NZAquaBots/nzaquabots.github.io/images/Kit parts.jpeg

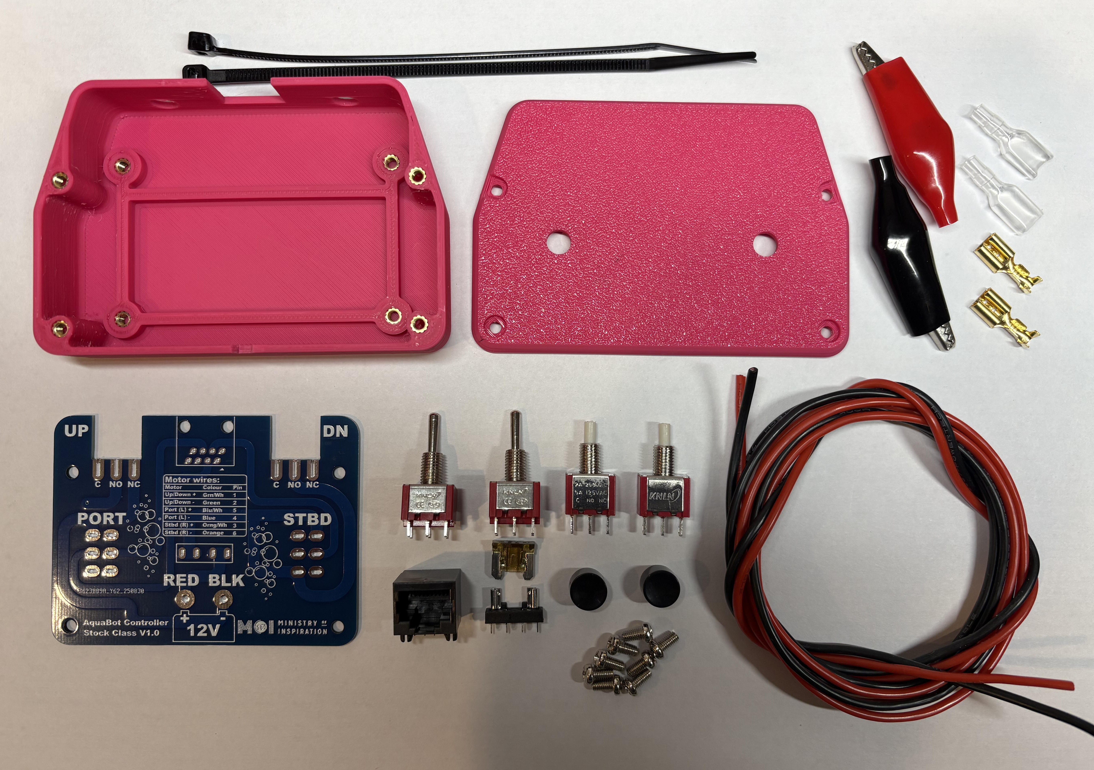
images/Kit parts.jpeg
