NZAquaBots/nzaquabots.github.io/images/PCB parts.jpeg

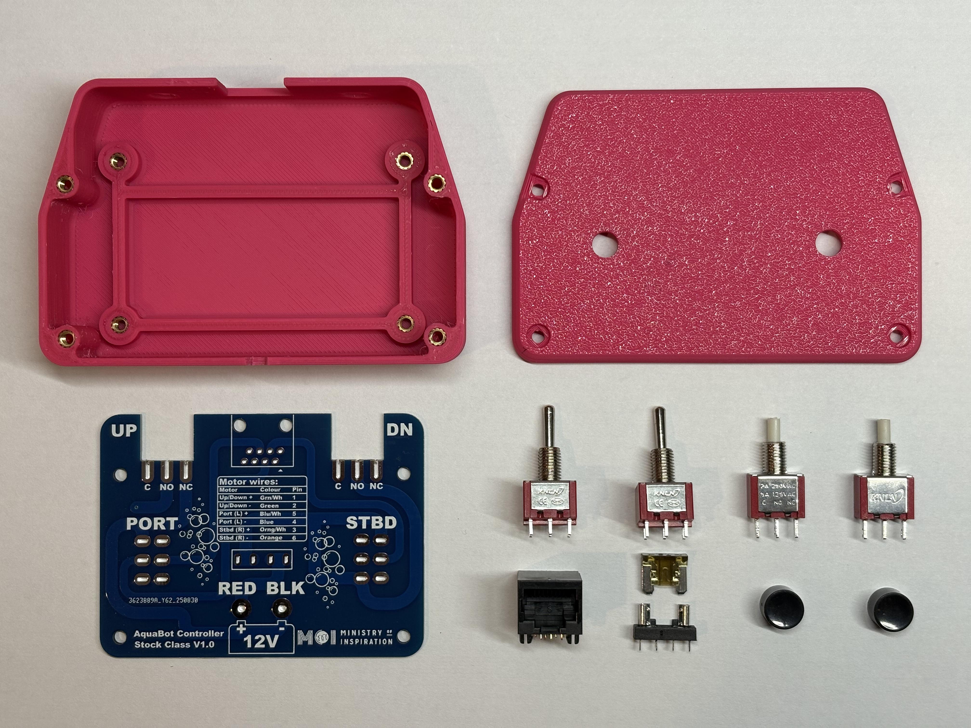
images/PCB parts.jpeg
