NZAquaBots/nzaquabots.github.io/ECAD/AquaBot Stock Controller Schematic.pdf

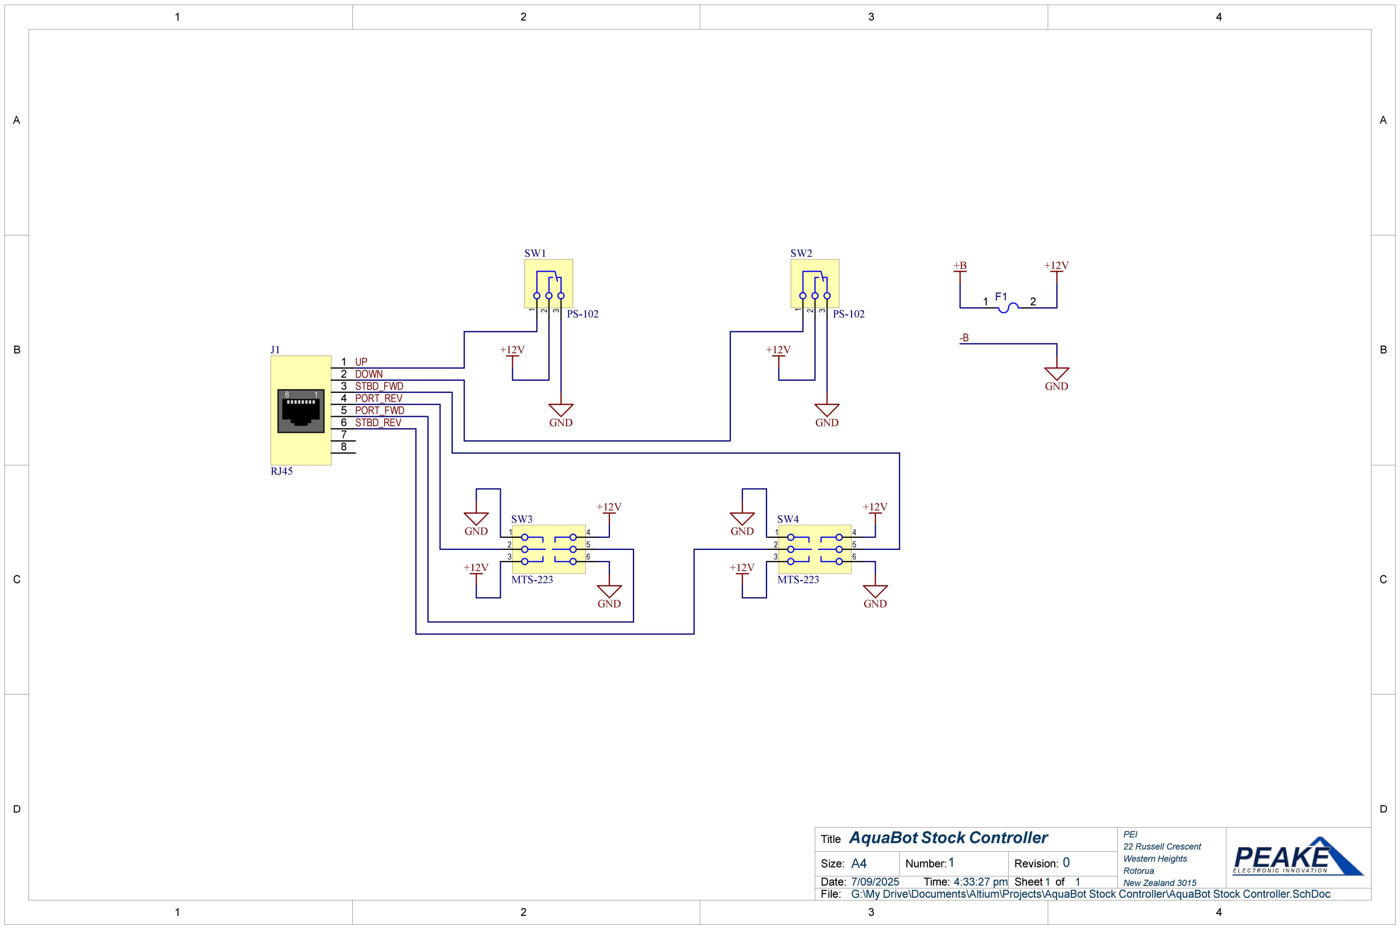
[picture p3: page 1]

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
### 22 Russell Crescent

Western Heights
Rotorua

### 1 New Zealand 3015

## AquaBot Stock Controller

1 0

7/09/2025 | 4:33:27 pm
G:\My Drive\Documents\Altium\Projects\AquaBot Stock Controller\AquaBot Stock Controller.SchDoc

Title

Size: | Number:
Date:
File:

Revision:
Time: | Sheet of

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
MTS-223

1
2

3

SW2

PS-102

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
RJ45

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
MTS-223

1
2

3

SW1

PS-102

+B | +12V

GND

-B
+12V | +12V
GND | GND
+12V | +12V
+12V | +12V
GND | GND
GND | GND

UP
DOWN
STBD_FWD

STBD_REV

PORT_FWD

PORT_REV
