NZAquaBots/nzaquabots.github.io/3d models/AngledEnclosure/AngledEnclosure.png

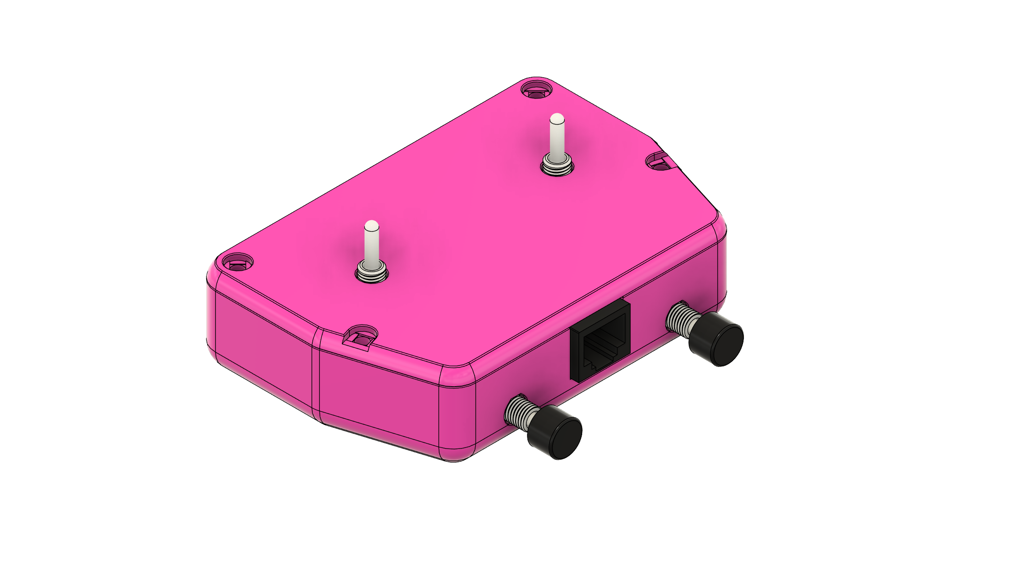
3d models/AngledEnclosure/AngledEnclosure.png
