NZAquaBots/nzaquabots.github.io/images/1.jpeg

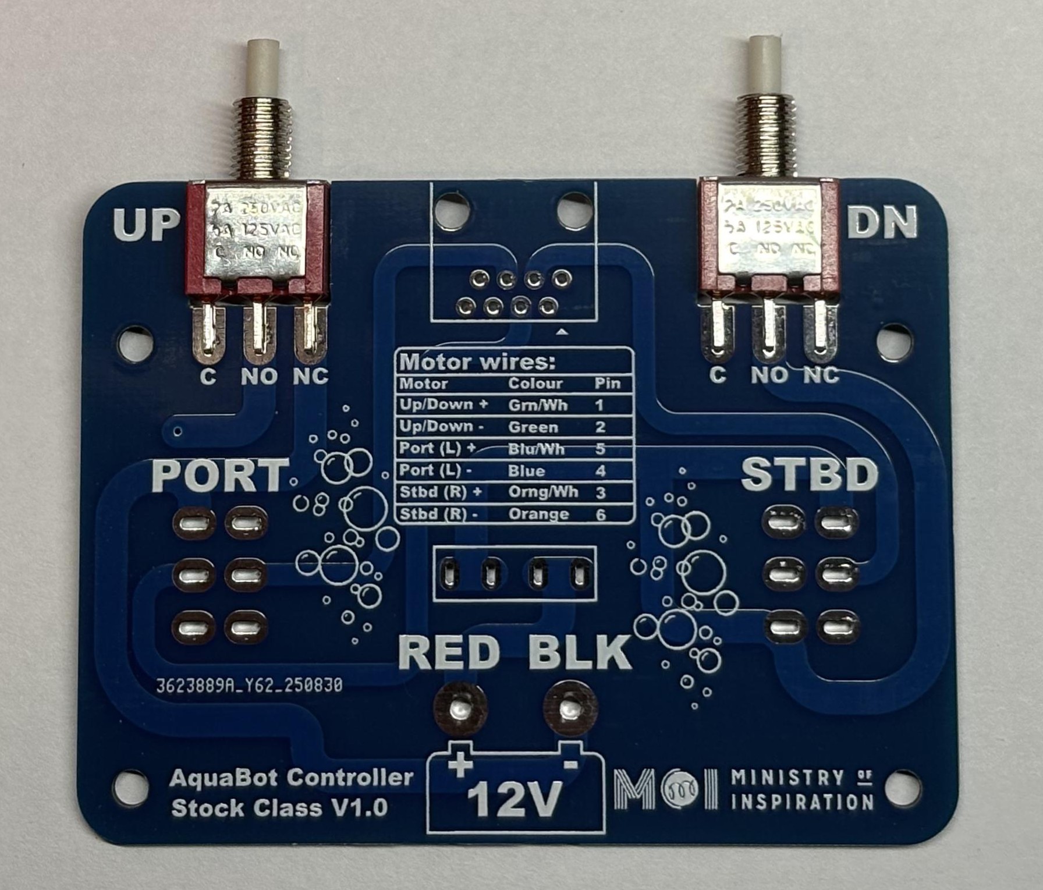
images/1.jpeg
