NZAquaBots/nzaquabots.github.io/images/2.jpeg

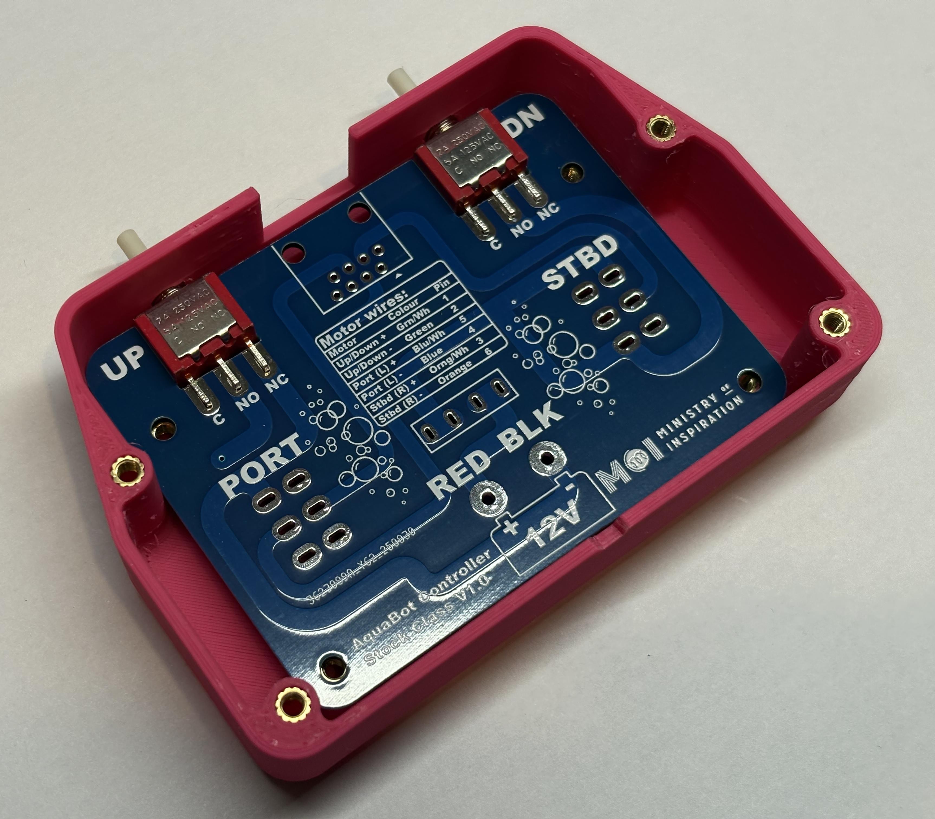
images/2.jpeg
