NZAquaBots/nzaquabots.github.io/images/3.jpeg

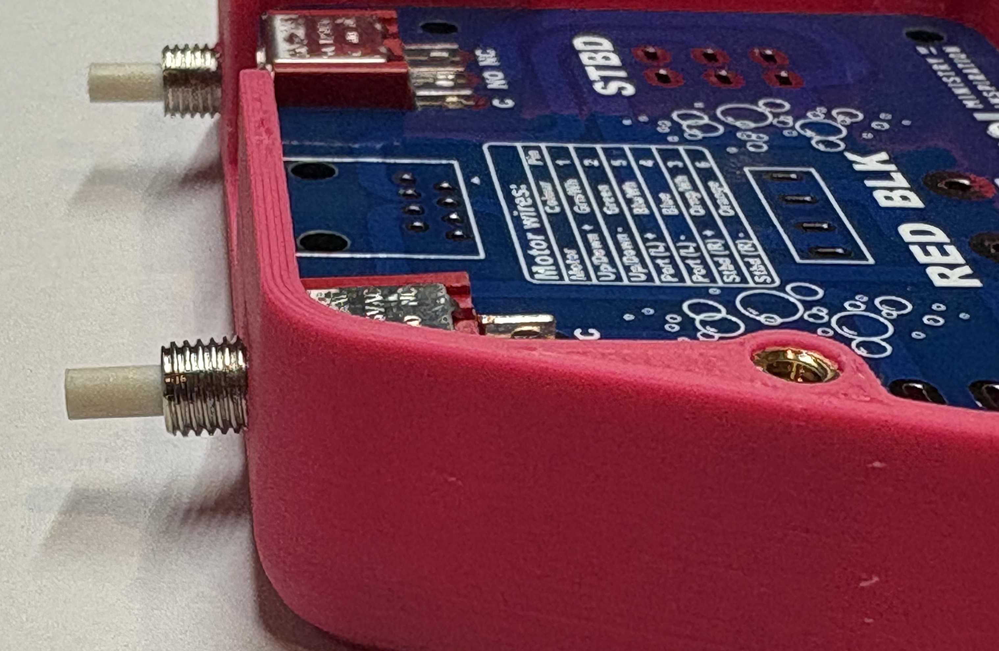
images/3.jpeg
