NZAquaBots/nzaquabots.github.io/images/4A.jpeg

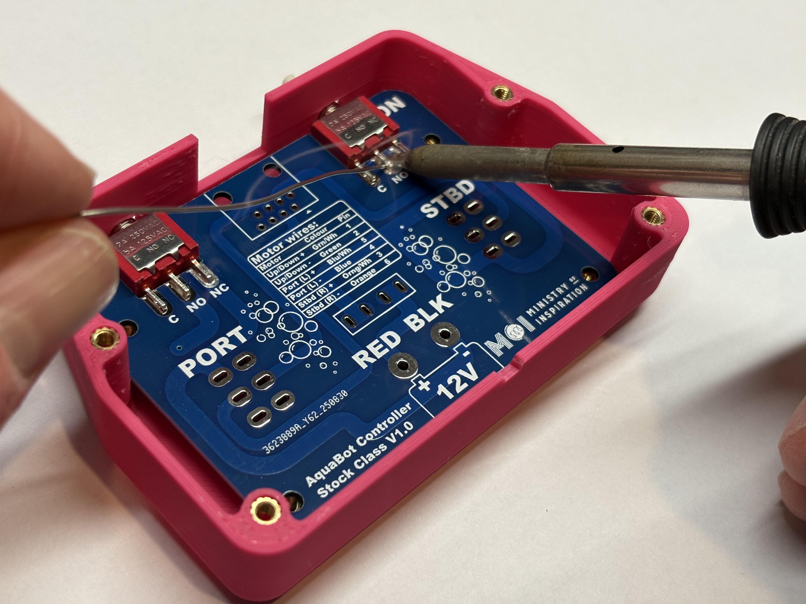
images/4A.jpeg
