NZAquaBots/nzaquabots.github.io/images/4B.jpeg

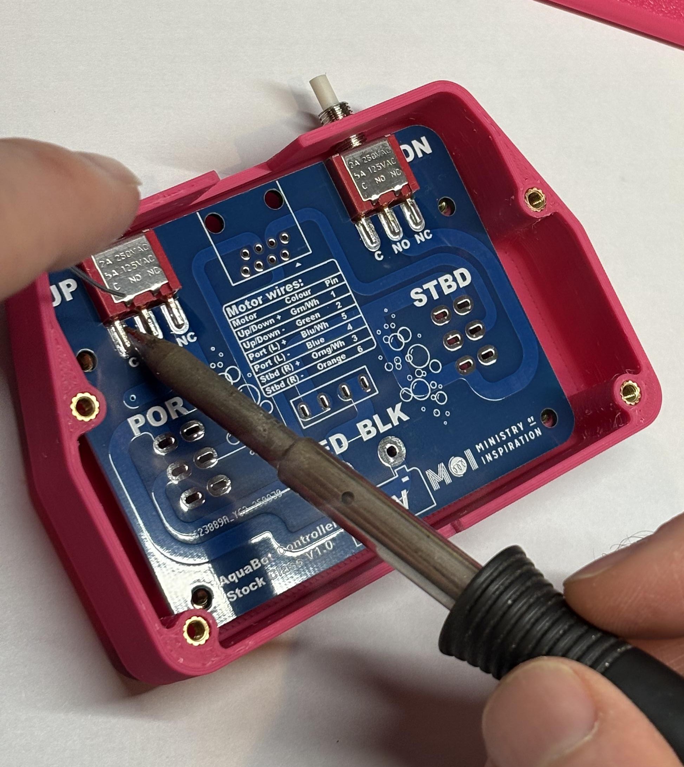
images/4B.jpeg
