NZAquaBots/nzaquabots.github.io/images/4C.jpeg

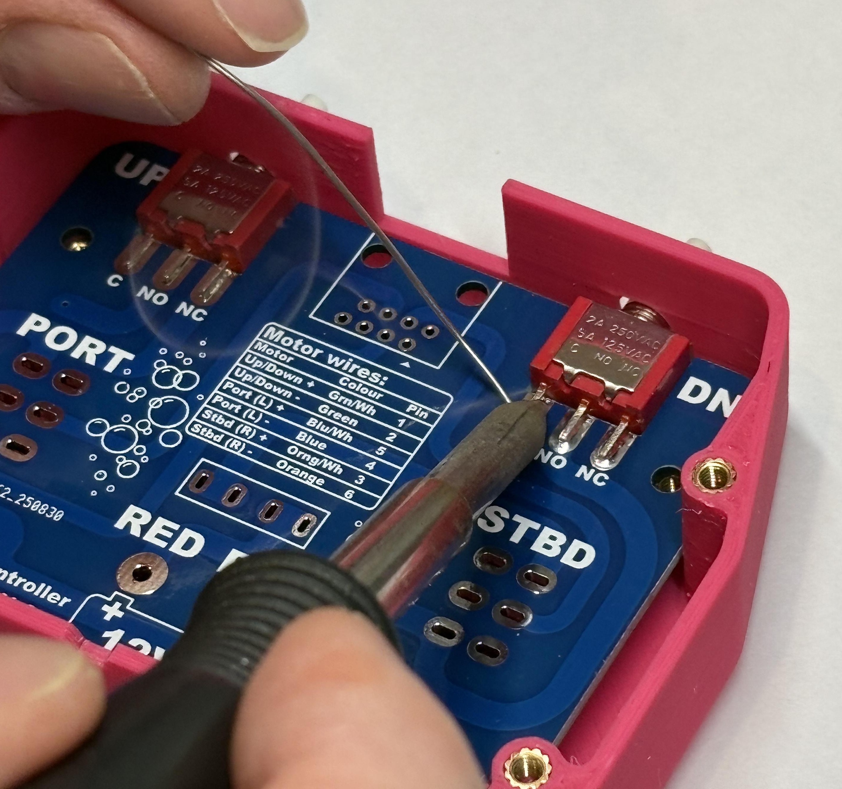
images/4C.jpeg
