NZAquaBots/nzaquabots.github.io/images/5.jpeg

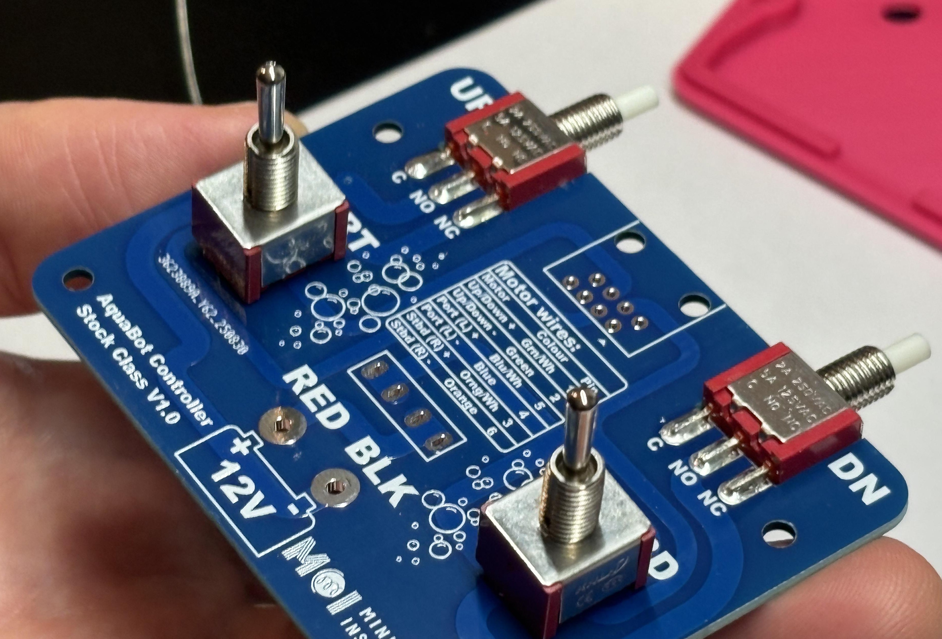
images/5.jpeg
