NZAquaBots/nzaquabots.github.io/images/6.jpeg

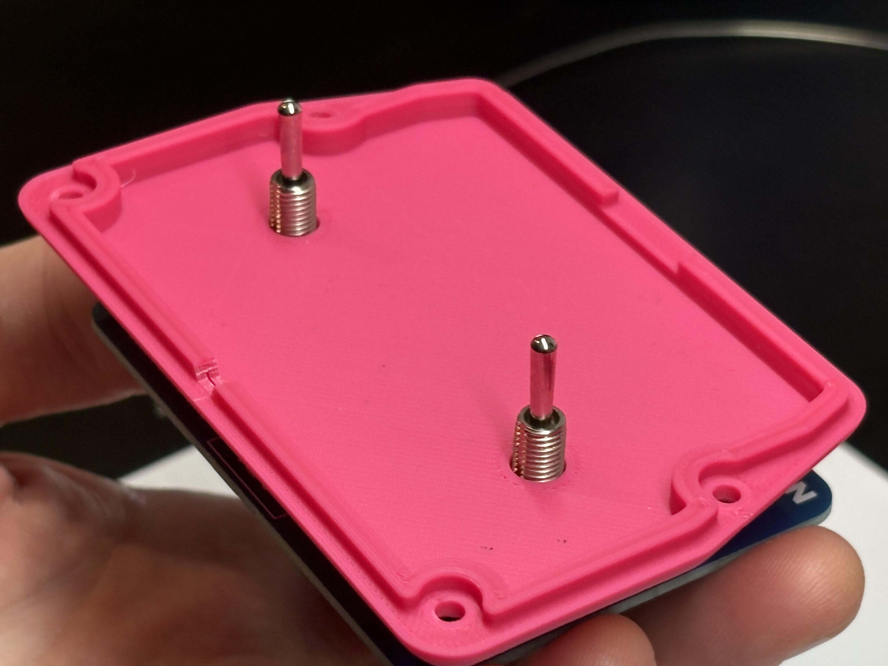
images/6.jpeg
