NZAquaBots/nzaquabots.github.io/images/7.jpeg

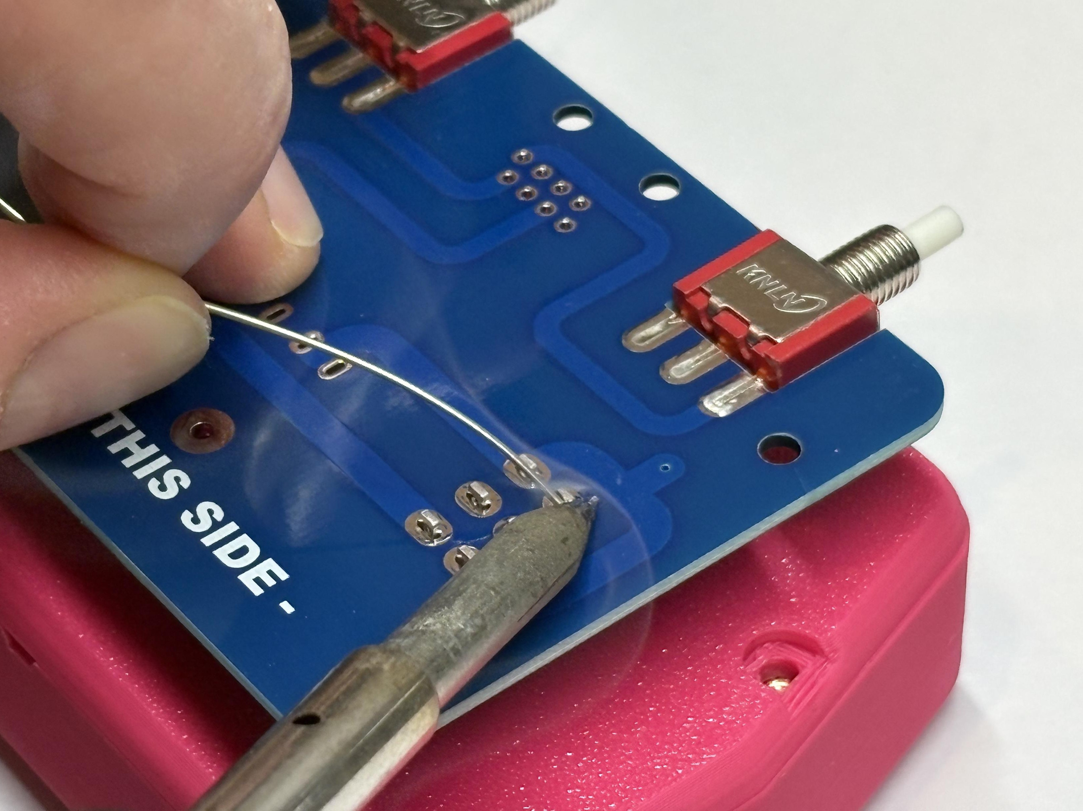
images/7.jpeg
