NZAquaBots/nzaquabots.github.io/images/8.jpeg

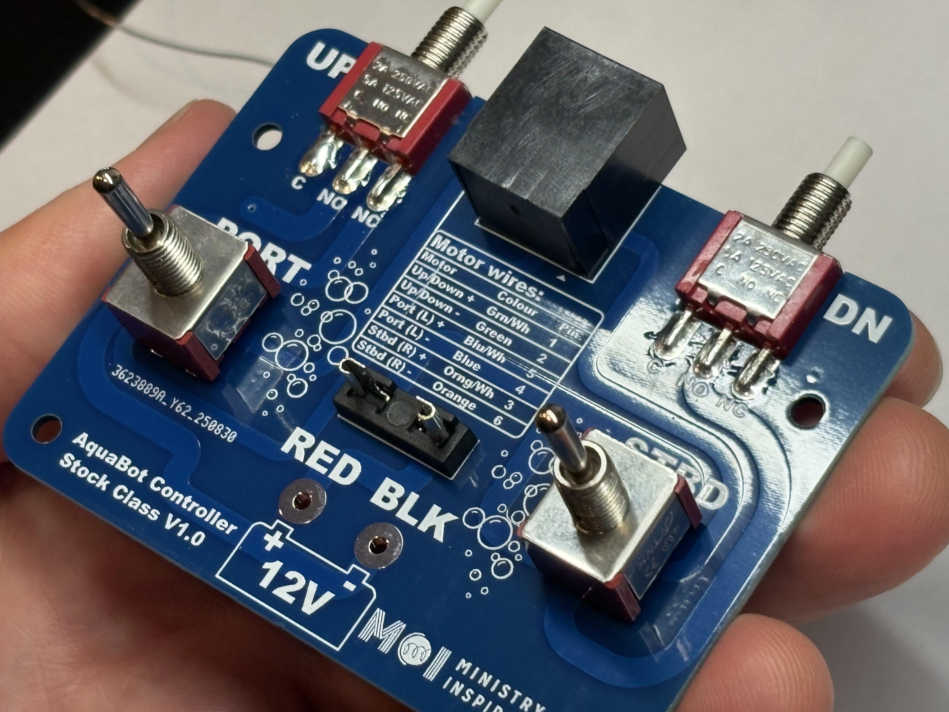
images/8.jpeg
