NZAquaBots/nzaquabots.github.io/images/9.jpeg

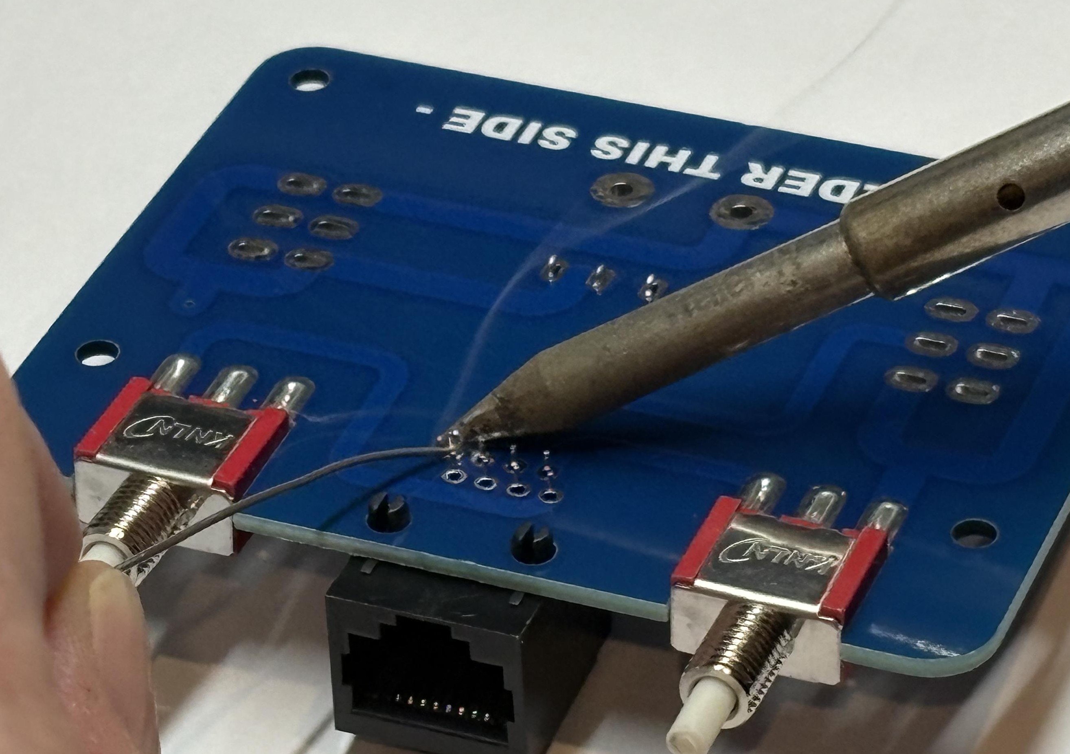
images/9.jpeg
