NZAquaBots/nzaquabots.github.io/images/10.jpeg

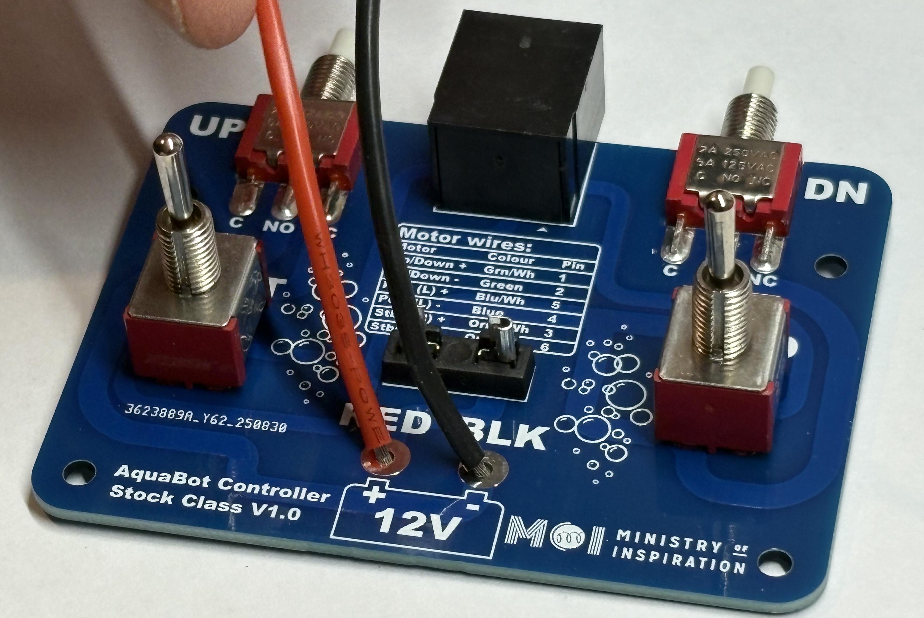
images/10.jpeg
