NZAquaBots/nzaquabots.github.io/images/11.jpeg

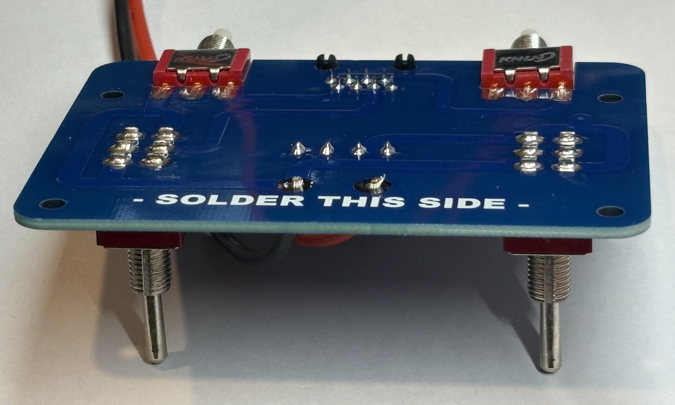
images/11.jpeg
