NZAquaBots/nzaquabots.github.io/images/12A.jpeg

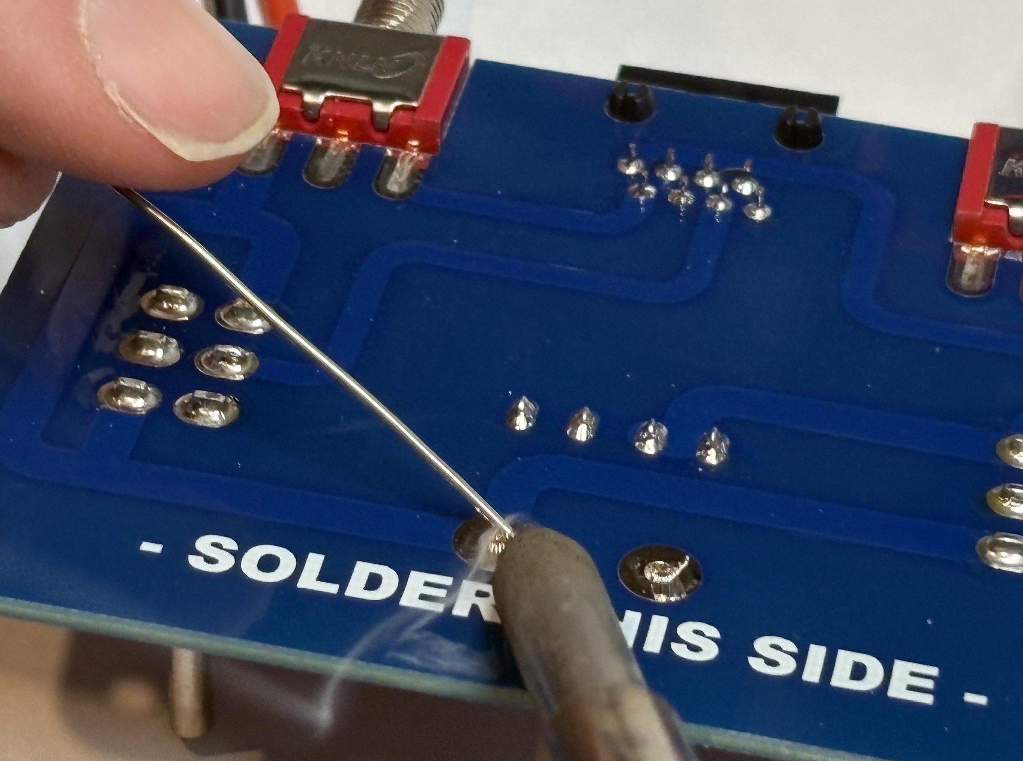
images/12A.jpeg
