NZAquaBots/nzaquabots.github.io/images/12B.jpeg

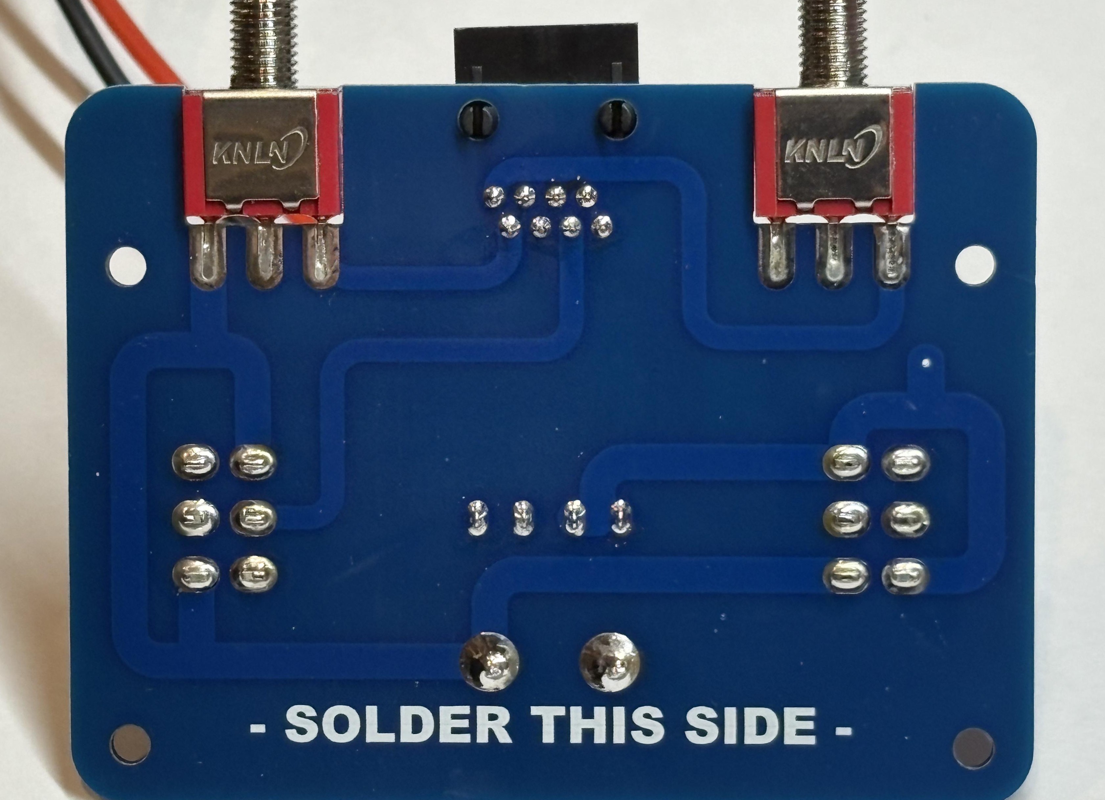
images/12B.jpeg
