NZAquaBots/nzaquabots.github.io/images/13.jpeg

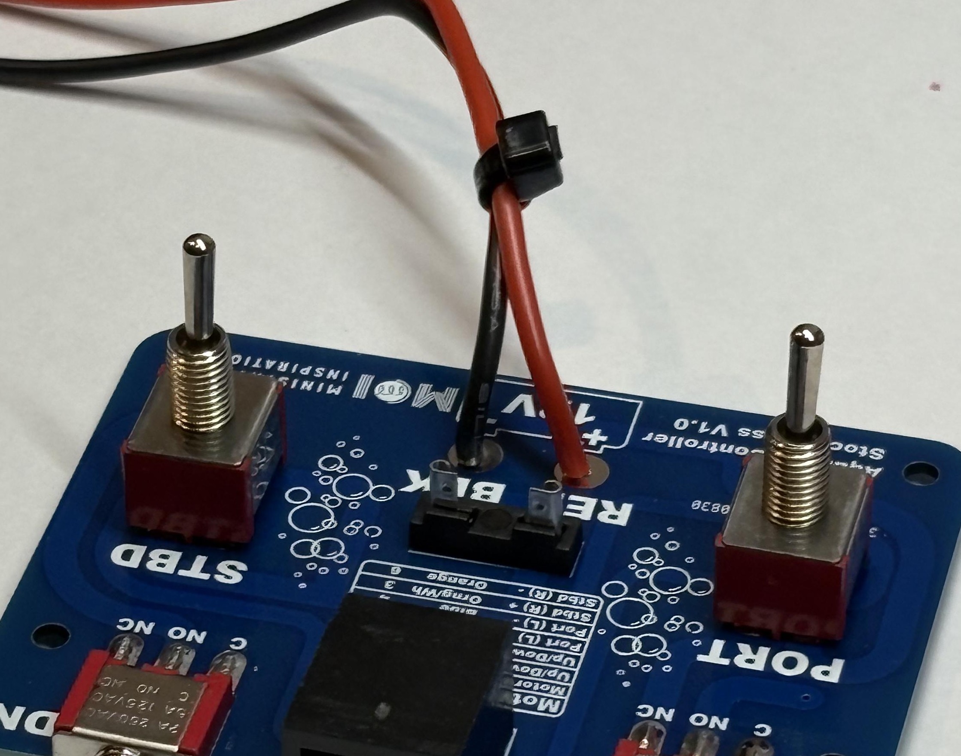
images/13.jpeg
