NZAquaBots/nzaquabots.github.io/images/14.jpeg

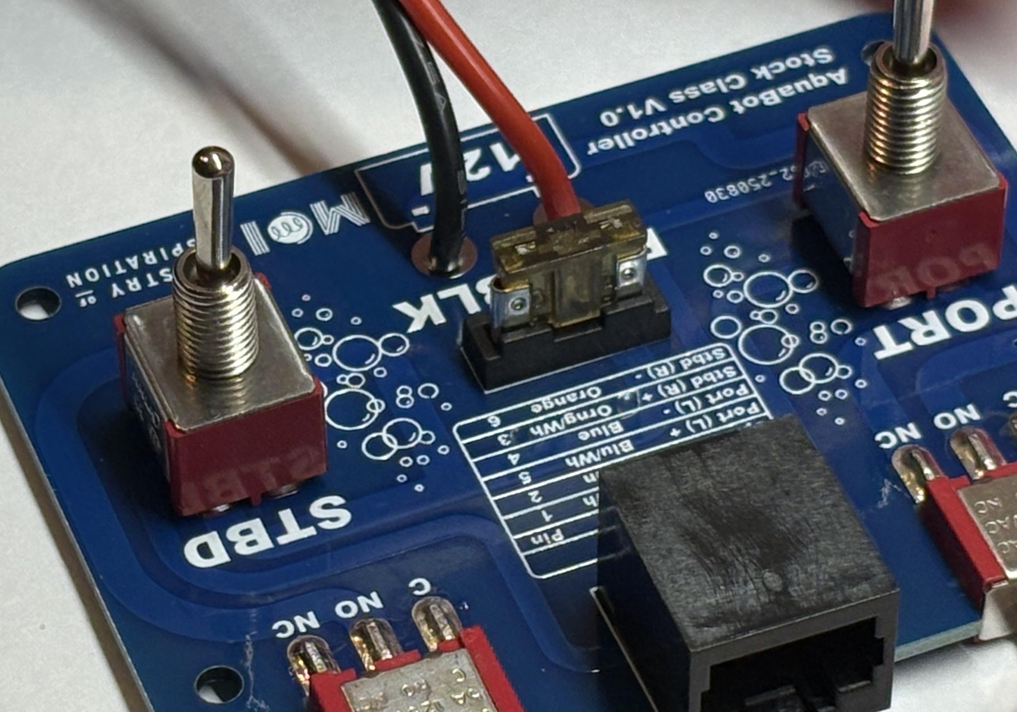
images/14.jpeg
