NZAquaBots/nzaquabots.github.io/images/15.jpeg

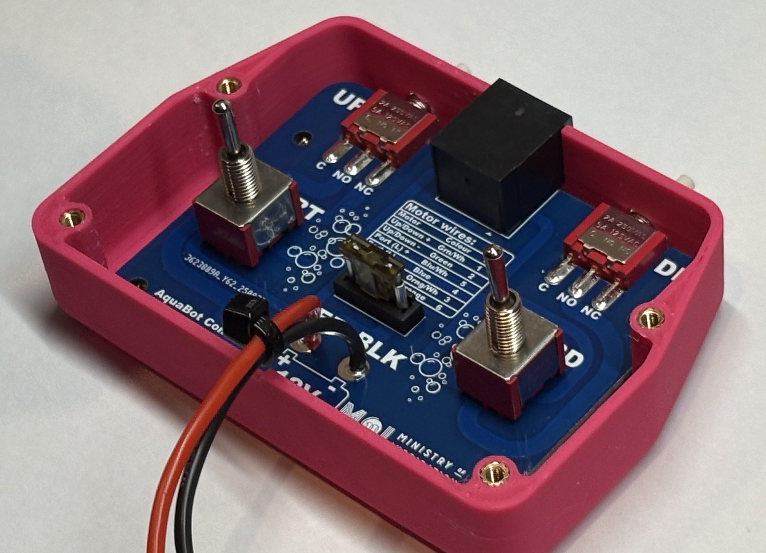
images/15.jpeg
