NZAquaBots/nzaquabots.github.io/images/16.jpeg

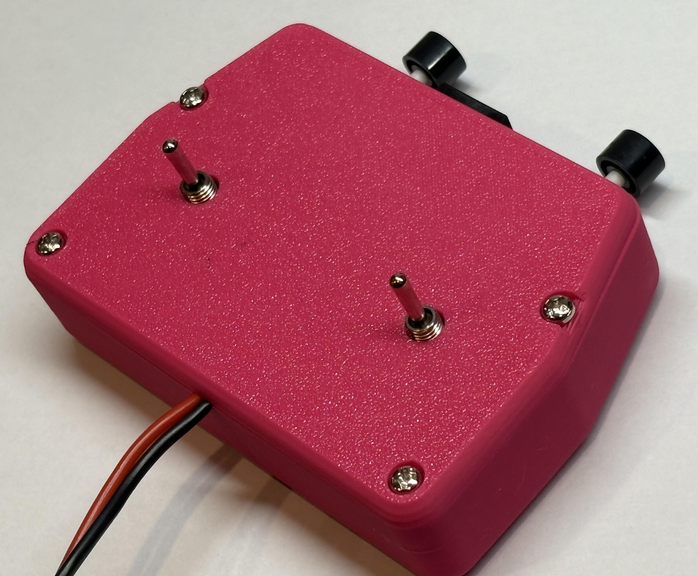
images/16.jpeg
