NZAquaBots/nzaquabots.github.io/images/17.jpeg

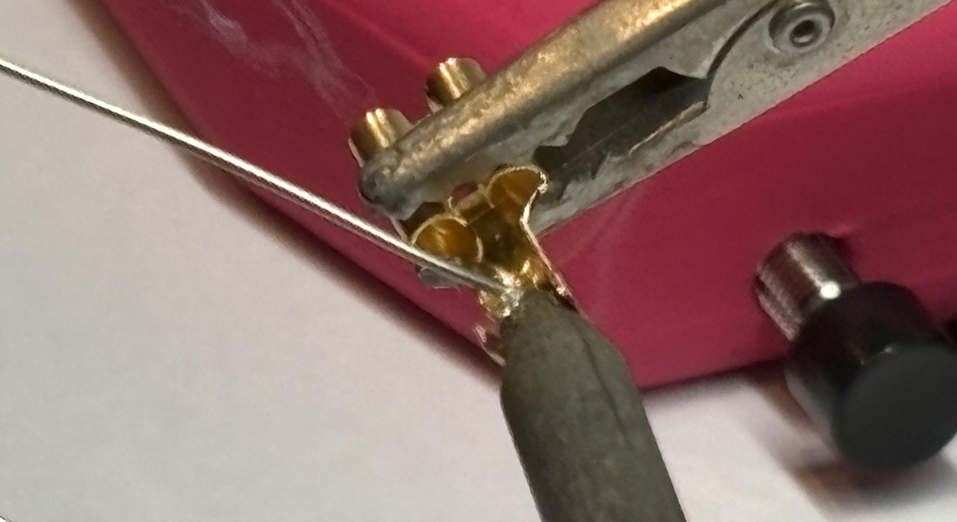
images/17.jpeg
