NZAquaBots/nzaquabots.github.io/images/18.jpeg

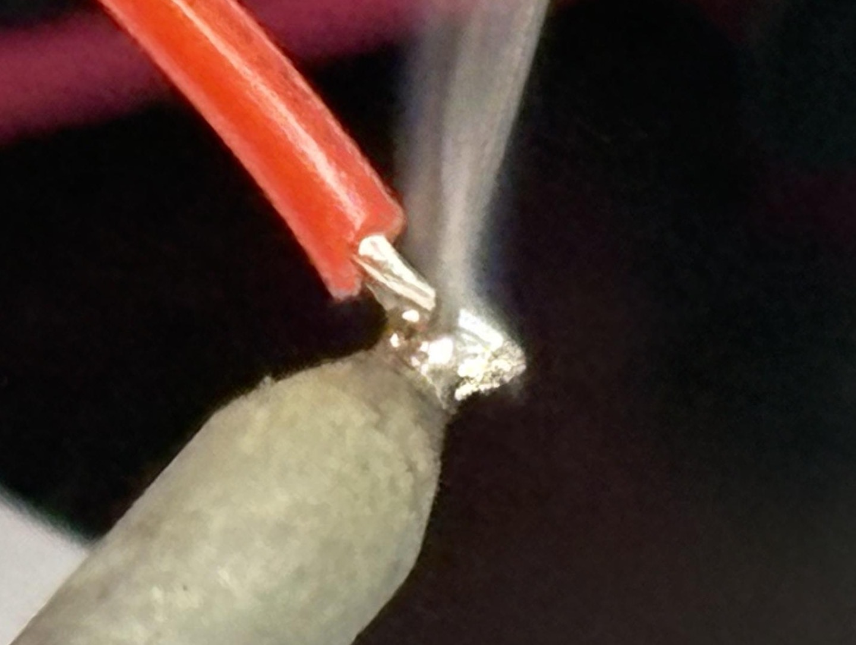
images/18.jpeg
