NZAquaBots/nzaquabots.github.io/images/19.jpeg

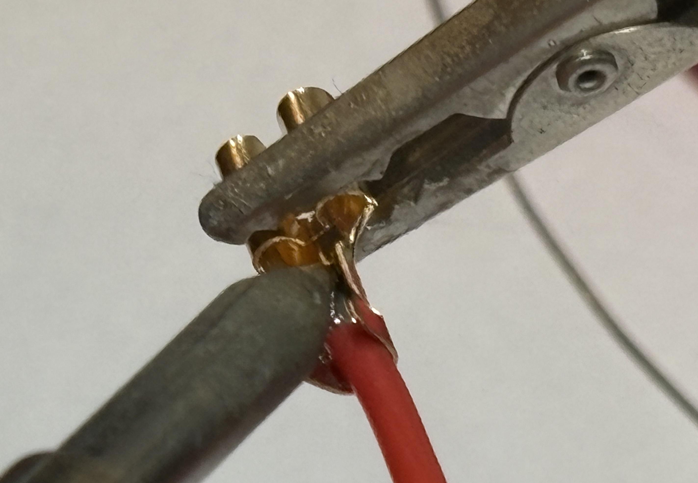
images/19.jpeg
