NZAquaBots/nzaquabots.github.io/images/20A.jpeg

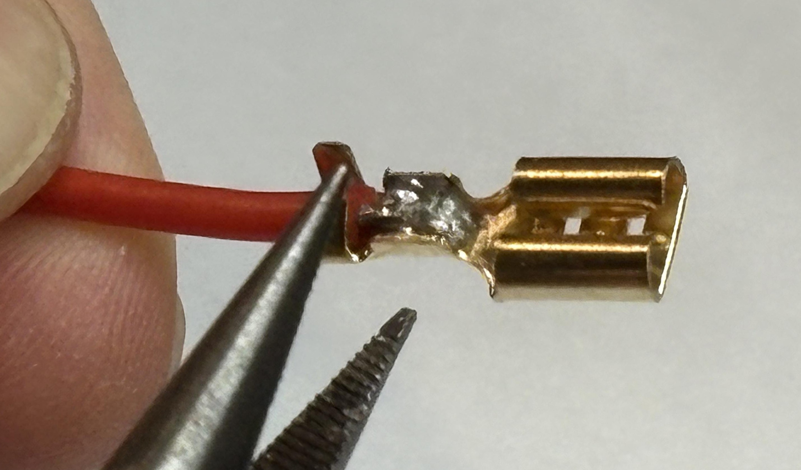
images/20A.jpeg
