NZAquaBots/nzaquabots.github.io/images/20B.jpeg

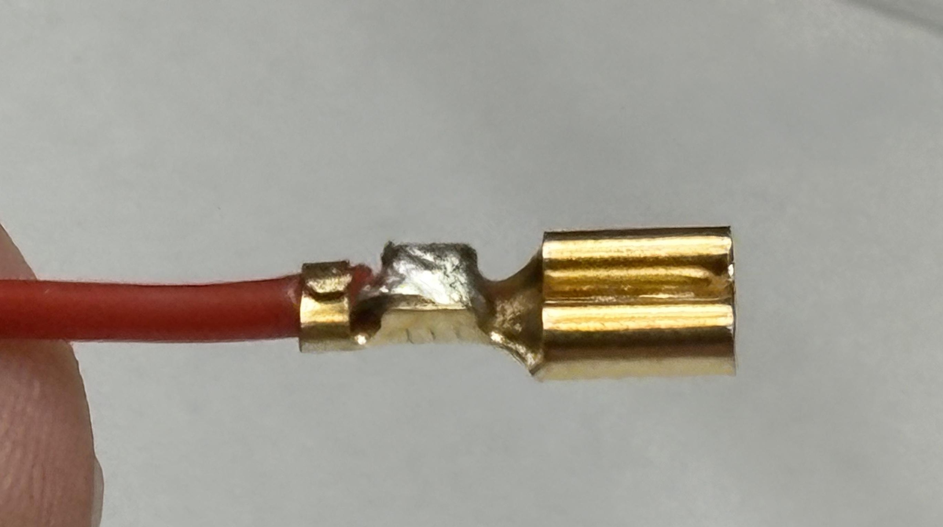
images/20B.jpeg
