NZAquaBots/nzaquabots.github.io/images/21A.jpeg

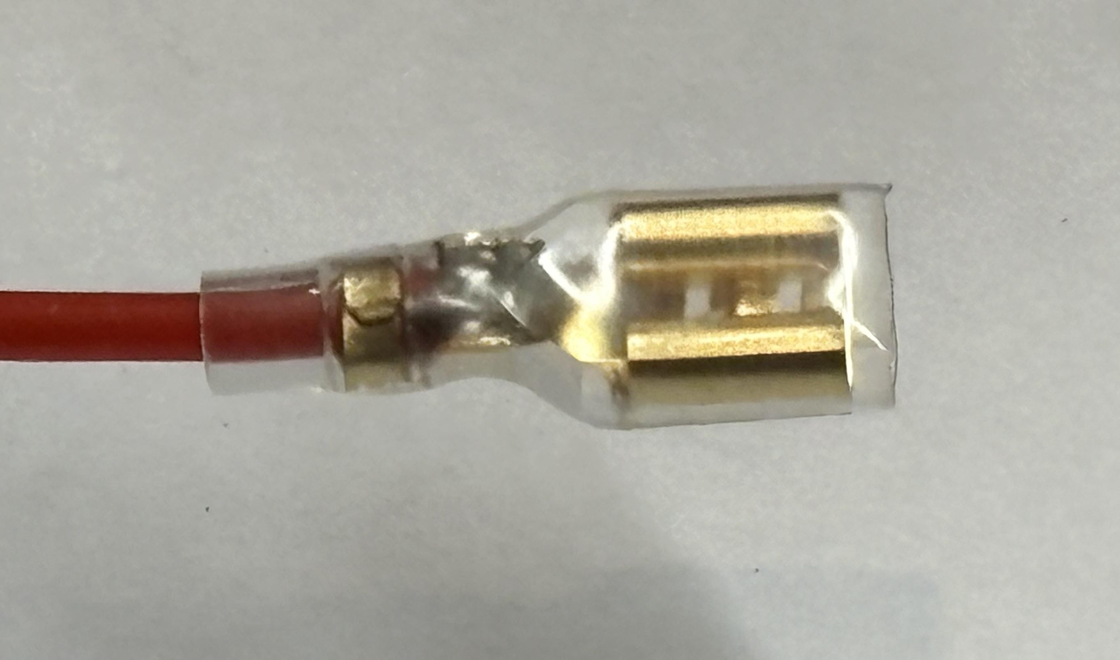
images/21A.jpeg
