NZAquaBots/nzaquabots.github.io/images/21B.jpeg

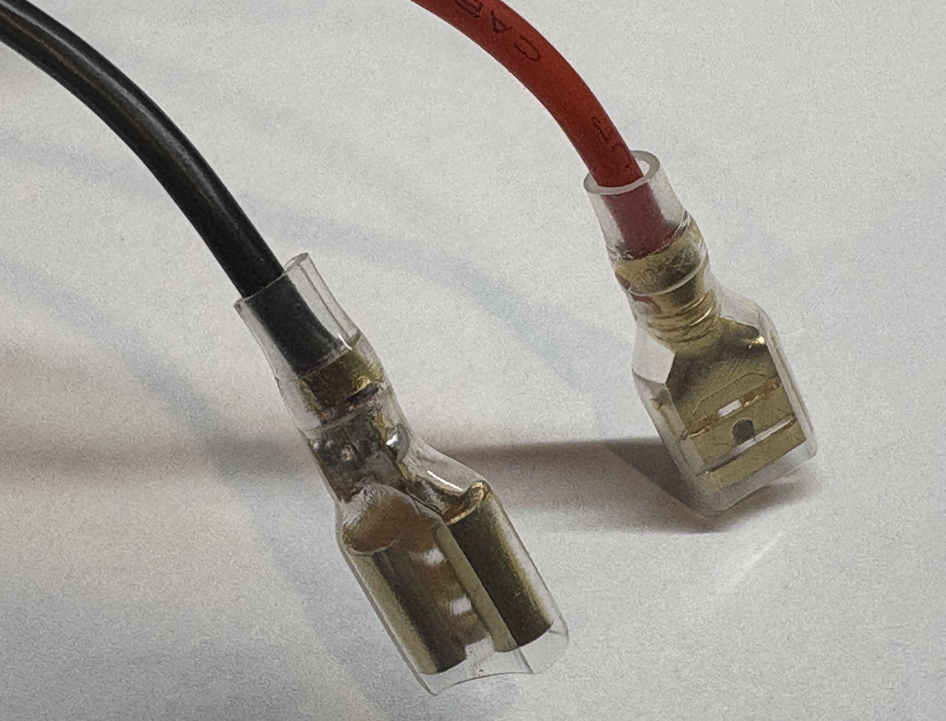
images/21B.jpeg
