NZAquaBots/nzaquabots.github.io/images/22.jpeg

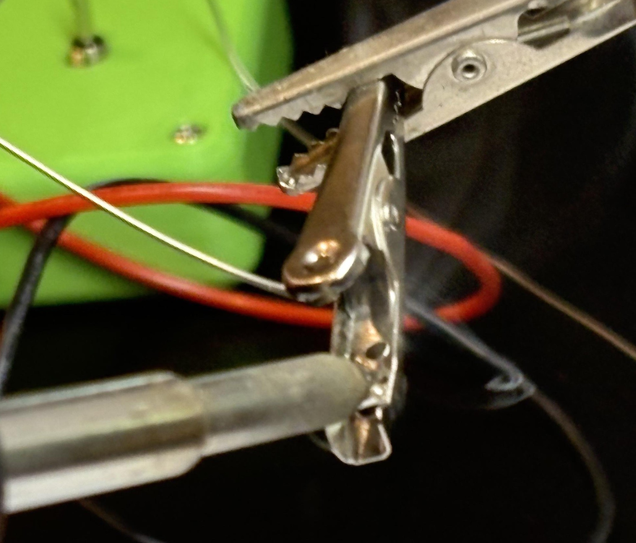
images/22.jpeg
