NZAquaBots/nzaquabots.github.io/images/23.jpeg

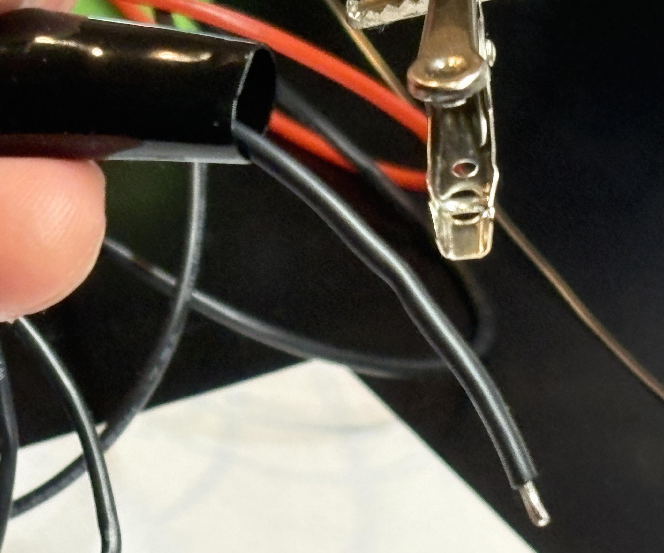
images/23.jpeg
