NZAquaBots/nzaquabots.github.io/images/24.jpeg

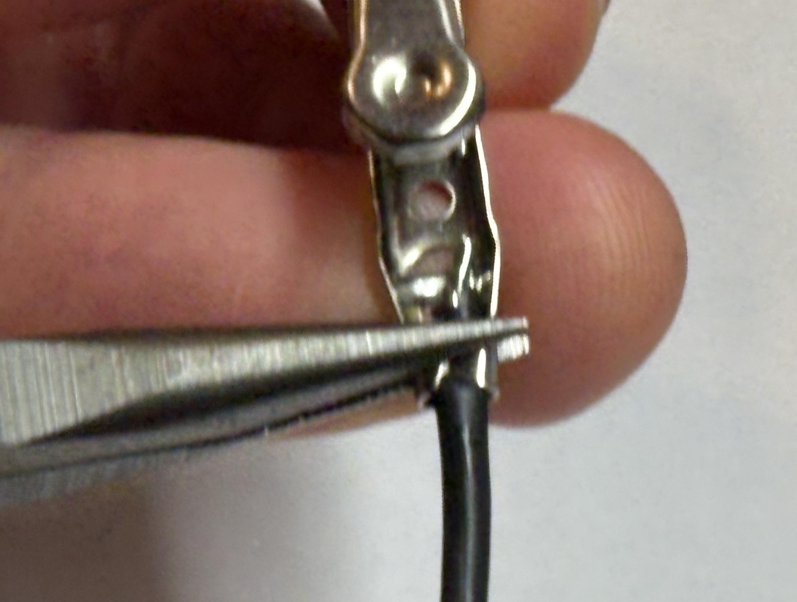
images/24.jpeg
