NZAquaBots/nzaquabots.github.io/images/25.jpeg

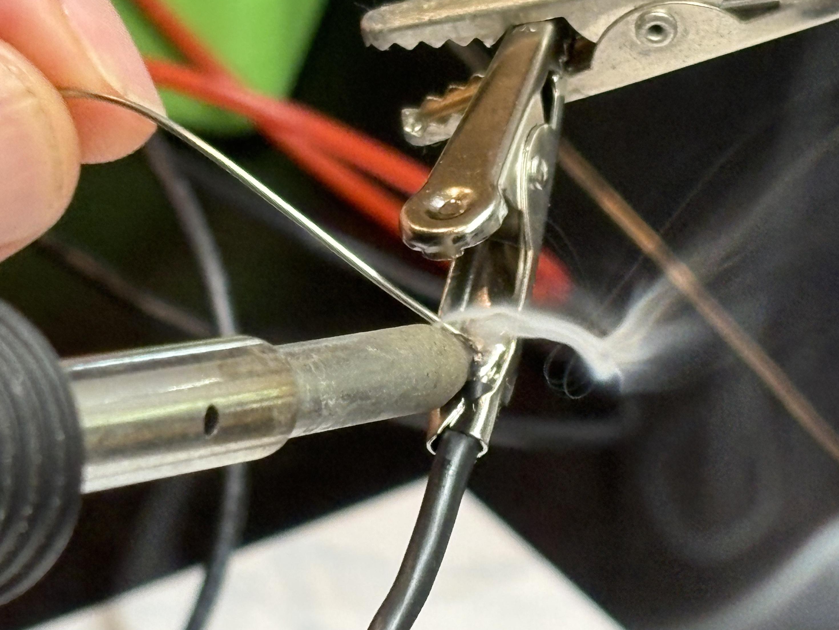
images/25.jpeg
