NZAquaBots/nzaquabots.github.io/images/26.jpeg

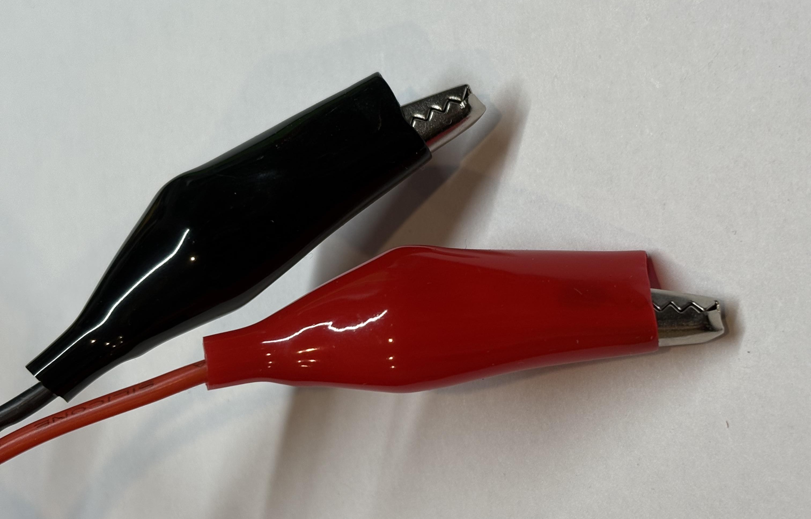
images/26.jpeg
