NZAquaBots/nzaquabots.github.io/images/Controllers.jpeg

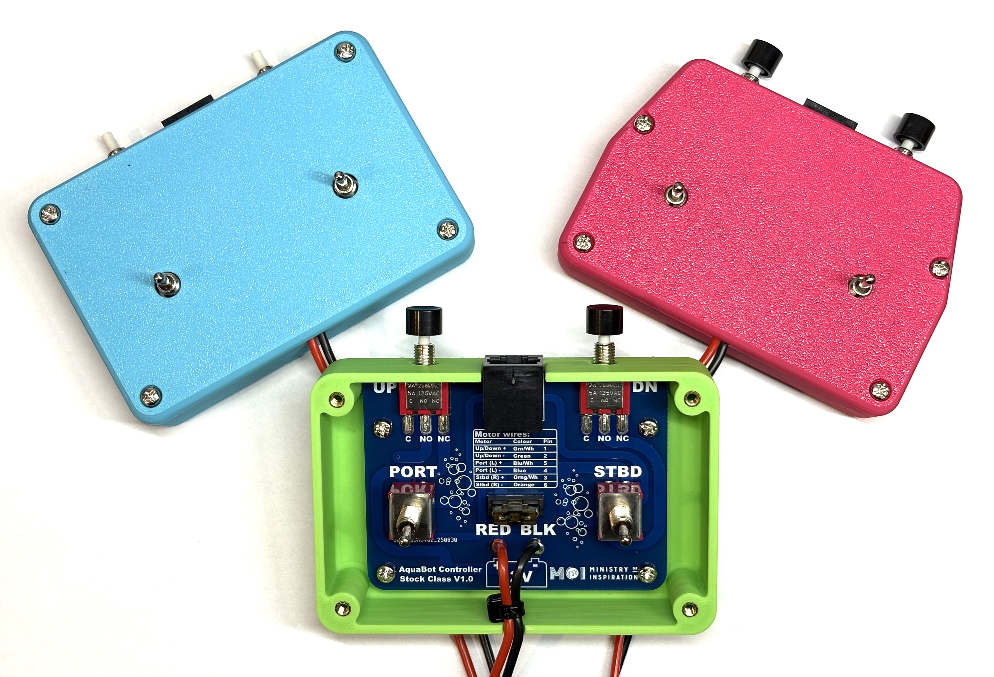
images/Controllers.jpeg
