NZAquaBots/nzaquabots.github.io/3d models/AngledEnclosure/AngledEnclosure.step

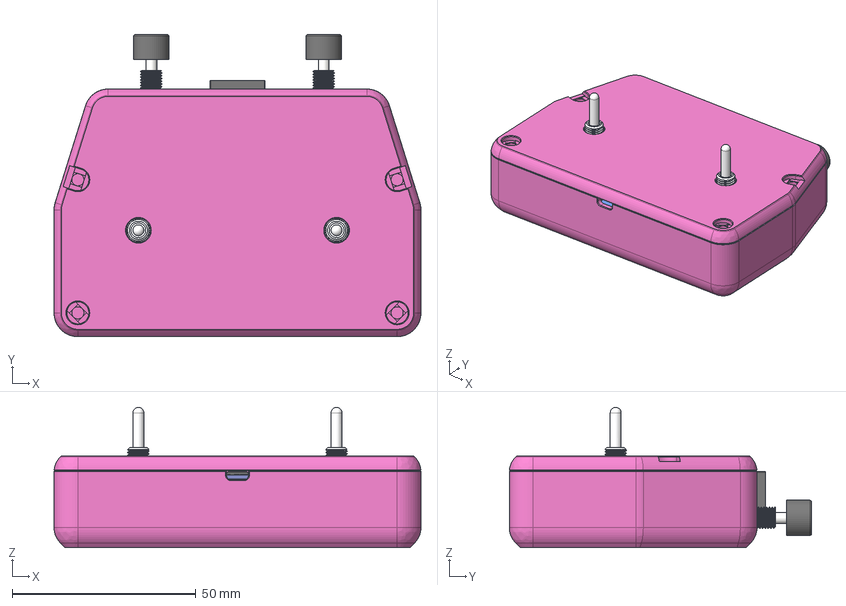
[picture p37: CAD file, 2025-09-07]
3d models/AngledEnclosure/AngledEnclosure.step
100.0 x 82.4 x 38.2 mm
MTS-223 x 2
PS-102 x 2
Filament
Contacts
Case
Rating
RJ45 5801-10P8C
