NZAquaBots/nzaquabots.github.io/3d models/BasicEnclosure/BasicEnclosure.step

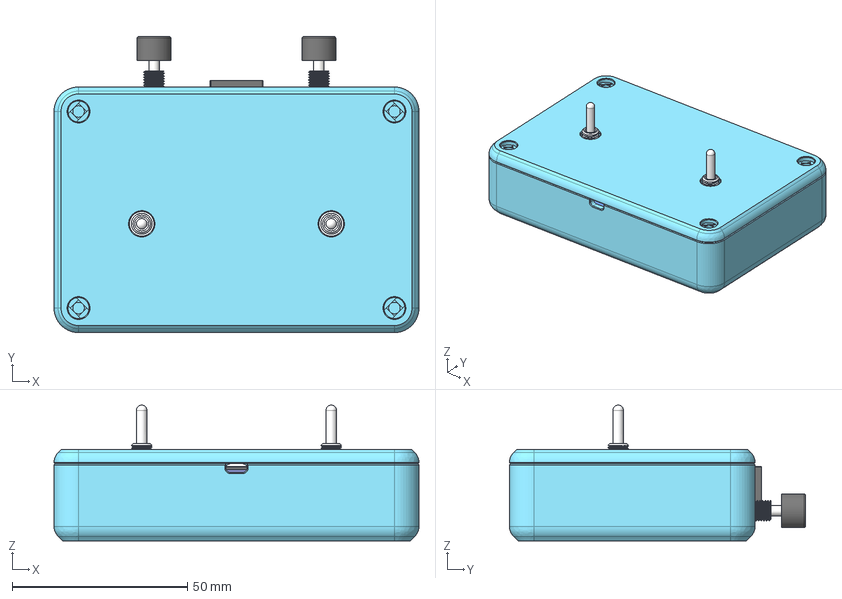
[picture p38: CAD file, 2025-09-07]
3d models/BasicEnclosure/BasicEnclosure.step
104.0 x 84.4 x 38.7 mm
MTS-223 x 2
PS-102 x 2
Filament
Contacts
Case
Rating
RJ45 5801-10P8C
