NZAquaBots/nzaquabots.github.io/ECAD/Altium/AquaBot Stock Controller.step

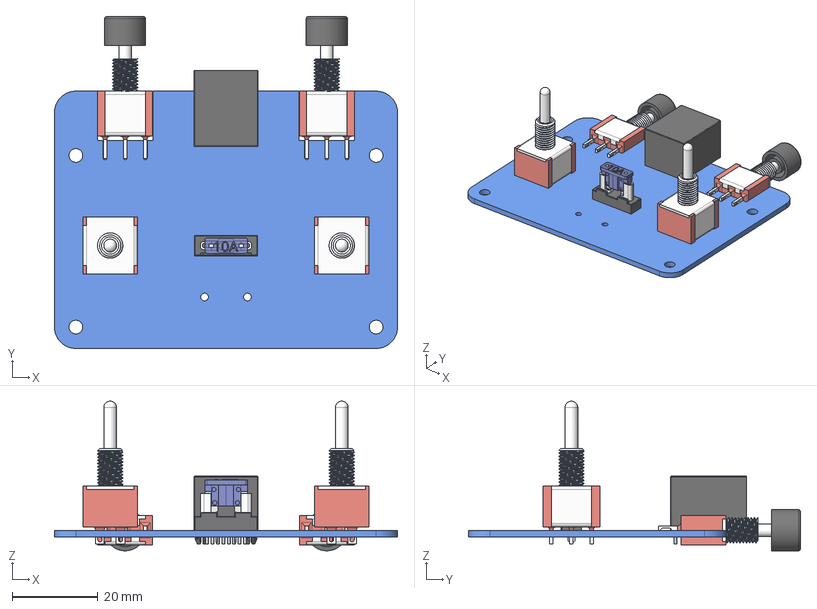
[picture p39: CAD file, 2025-09-07]
ECAD/Altium/AquaBot Stock Controller.step
80.0 x 77.4 x 34.9 mm
MTS-223 x 2
PS-102 x 2
RJ45 5801-10P8C
Filament
Contacts
Case
Rating
