NZAquaBots/nzaquabots.github.io/3d models/AngledEnclosure/Case.3mf

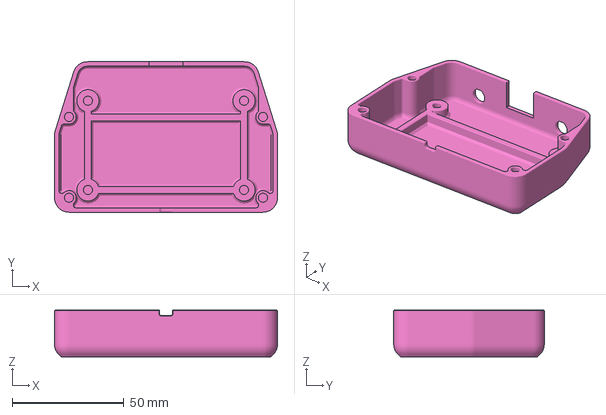
[picture p40: CAD file, 2025-09-07]
3d models/AngledEnclosure/Case.3mf
100.0 x 67.5 x 21.0 mm
