NZAquaBots/nzaquabots.github.io/3d models/BasicEnclosure/Case.3mf

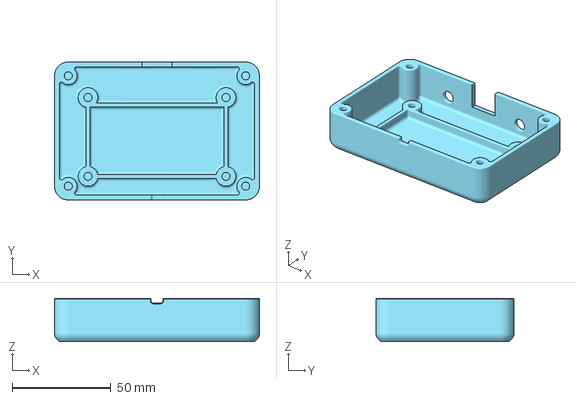
[picture p41: CAD file, 2025-09-07]
3d models/BasicEnclosure/Case.3mf
104.0 x 70.0 x 22.0 mm
