NZAquaBots/nzaquabots.github.io/3d models/AngledEnclosure/Lid.3mf

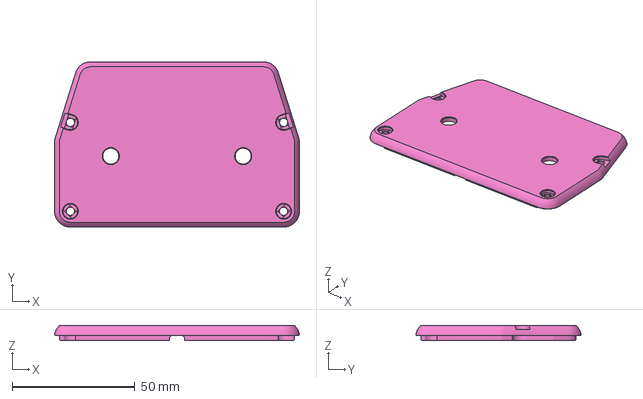
[picture p42: CAD file, 2025-09-07]
3d models/AngledEnclosure/Lid.3mf
100.0 x 67.5 x 6.00 mm
