NZAquaBots/nzaquabots.github.io/3d models/BasicEnclosure/Lid.3mf

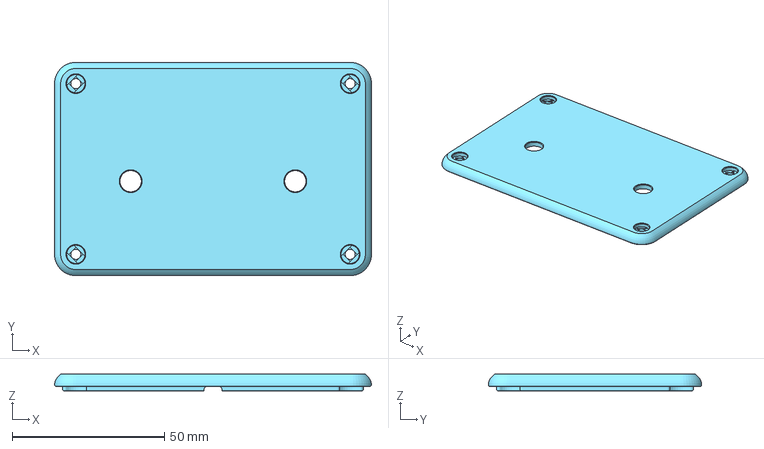
[picture p43: CAD file, 2025-09-07]
3d models/BasicEnclosure/Lid.3mf
104.0 x 70.0 x 5.50 mm
