NZAquaBots/nzaquabots.github.io/(list of files, drawings)

Other design files:
ECAD/Altium/AquaBot Stock Controller.PcbDoc
ECAD/Altium/AquaBot Stock Controller.PrjPcb
ECAD/Altium/AquaBot Stock Controller.SchDoc
