NZAquaBots/nzaquabots.github.io/(commit log)

2025-09-07 Emphasis on switch orientation
2025-09-16 PCB fab files added
2026-03-06 Added print button and formatting
